Raagam-Parmar/Open_Faucet_Detector/Gallery/Design Sketch 3.jpg

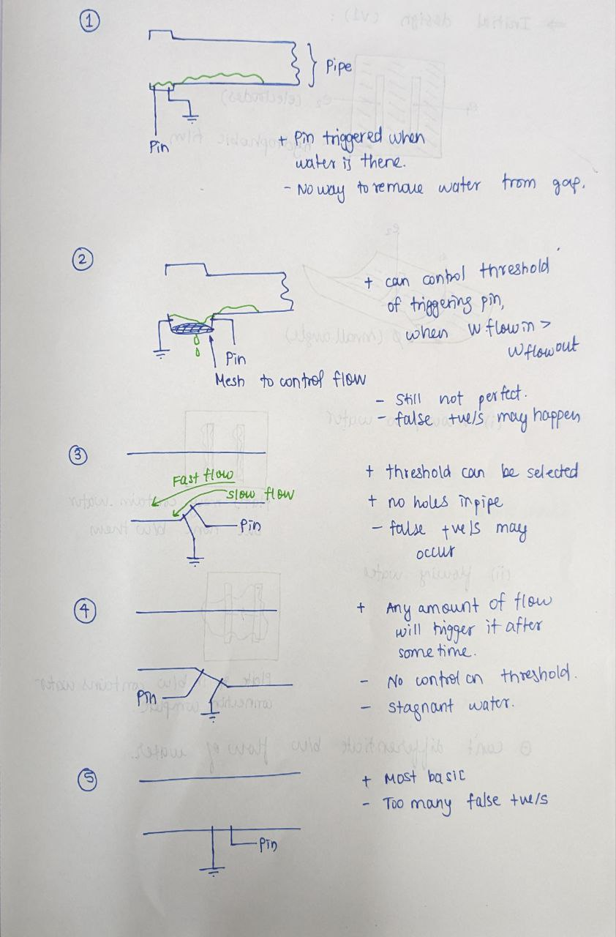
Gallery/Design Sketch 3.jpg
