Raagam-Parmar/Open_Faucet_Detector/Gallery/Design Sketch 2.jpg

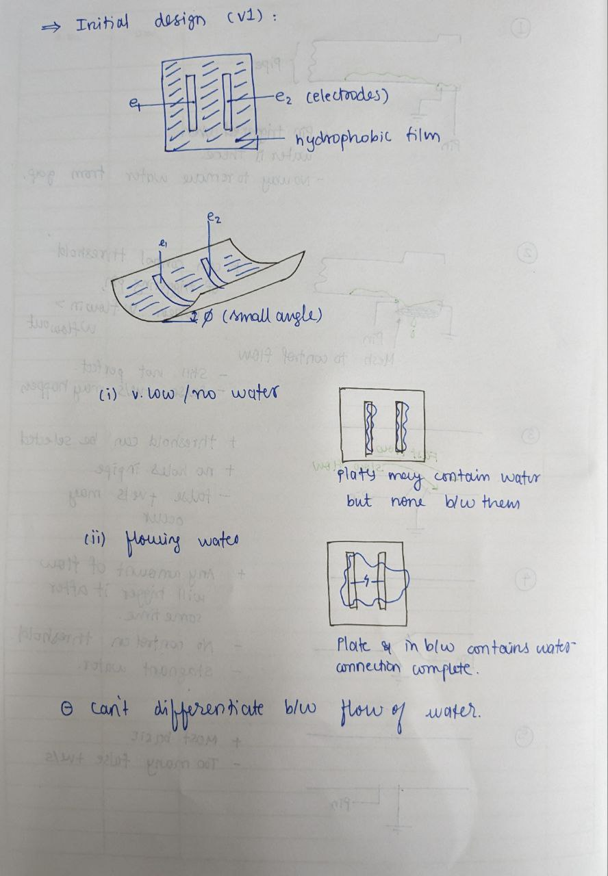
Gallery/Design Sketch 2.jpg
