Raagam-Parmar/Open_Faucet_Detector/Gallery/Prototype Image 3.jpg

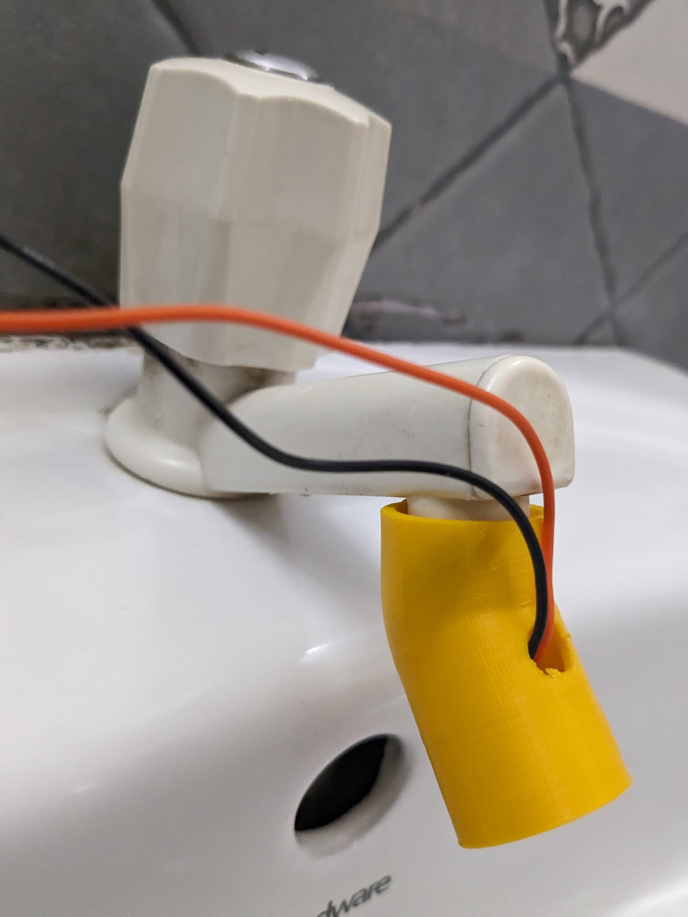
Gallery/Prototype Image 3.jpg
