Raagam-Parmar/Open_Faucet_Detector/Gallery/Prototype Image 4.jpg

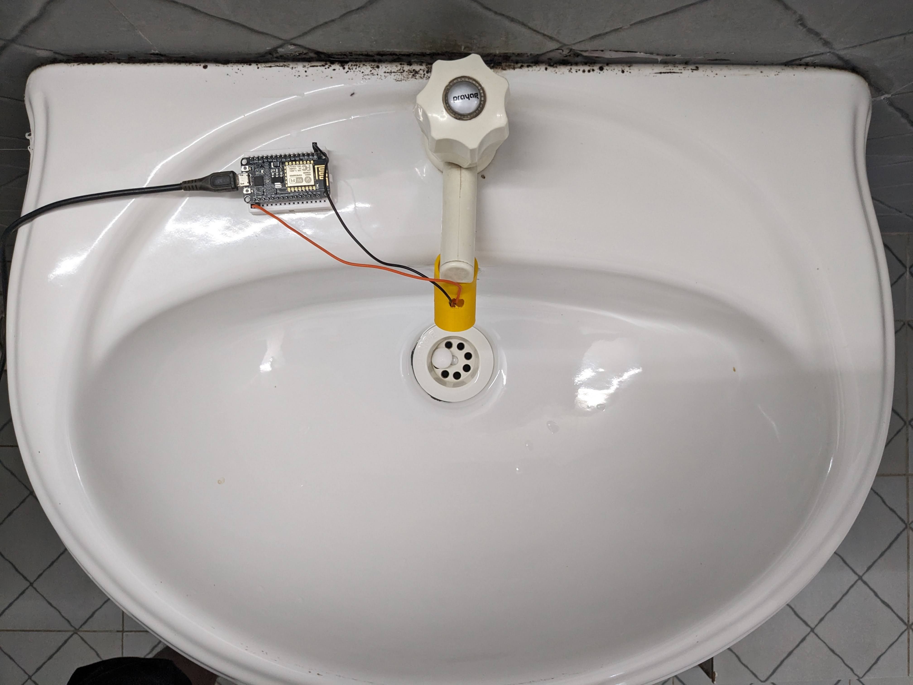
Gallery/Prototype Image 4.jpg
