Raagam-Parmar/Open_Faucet_Detector/Gallery/Prototype Image 5.jpg

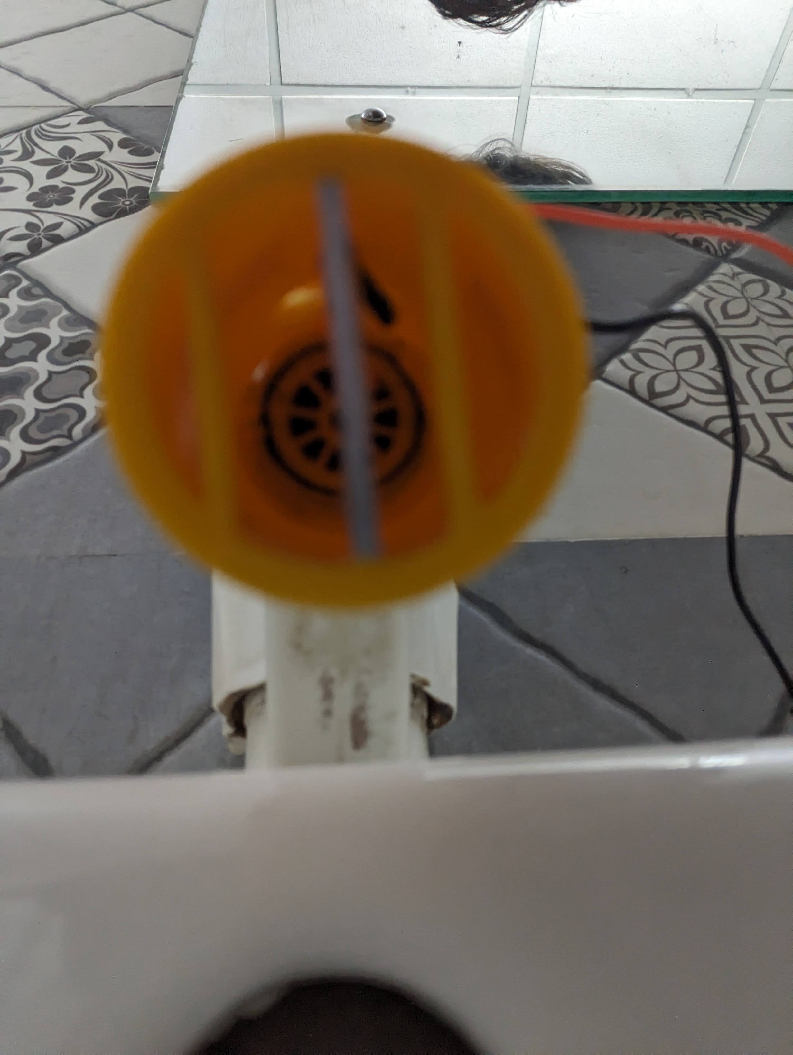
Gallery/Prototype Image 5.jpg
