Raagam-Parmar/Open_Faucet_Detector/Gallery/Prptotype Image 2.jpg

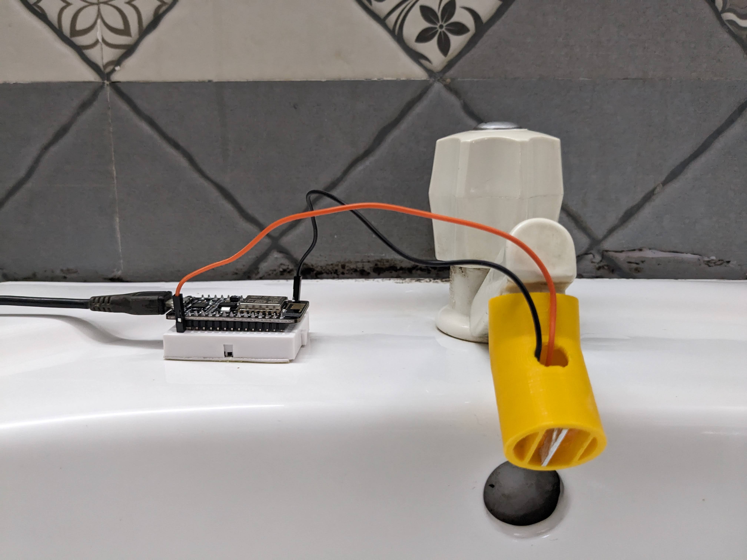
Gallery/Prptotype Image 2.jpg
