Raagam-Parmar/Open_Faucet_Detector/3D Models/(4,6) Prototype v9.11 (8mm hole, 30deg tilt, 11mm gap).stl

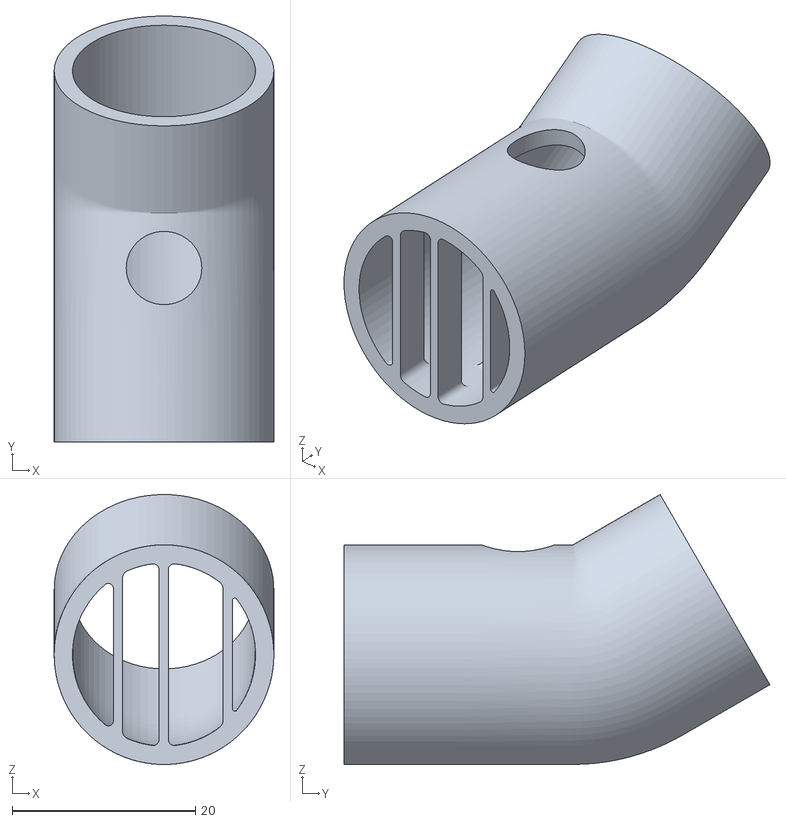
[picture p12: CAD file, 2023-12-01]
3D Models/(4,6) Prototype v9.11 (8mm hole, 30deg tilt, 11mm gap).stl
24.0 x 46.5 x 29.5
