Raagam-Parmar/Open_Faucet_Detector/(list of files, cad)

Other CAD files:
3D Models/(4,6) Prototype v12.f3d
